goran-mahovlic/mppt-charge-controller/README.md

# MTTP Charge Controller

Adapted from Byte Sized Projects for MEGAphone
Used and released under GPLv3

# mppt charge controller
 
BQ 24650 datasheet can be found here https://www.ti.com/general/docs/suppproductinfo.tsp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
