goran-mahovlic/mppt-charge-controller/Electrical-Design/Solder Paste Jig.3mf

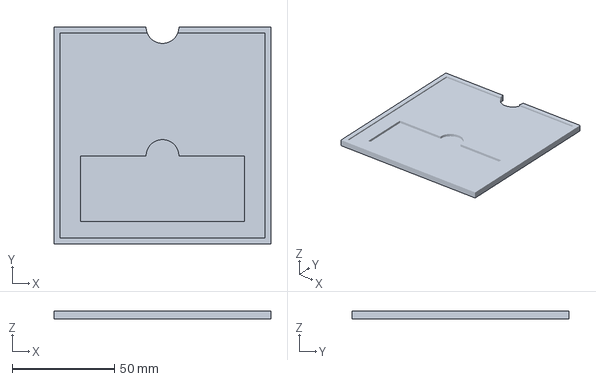
[picture p1: CAD file, 2025-08-11]
Electrical-Design/Solder Paste Jig.3mf
106.0 x 106.0 x 4.00 mm
