goran-mahovlic/mppt-charge-controller/Electrical-Design/MPPT-Charge-Controller-KiCad/MPPT Charge Controller.pdf

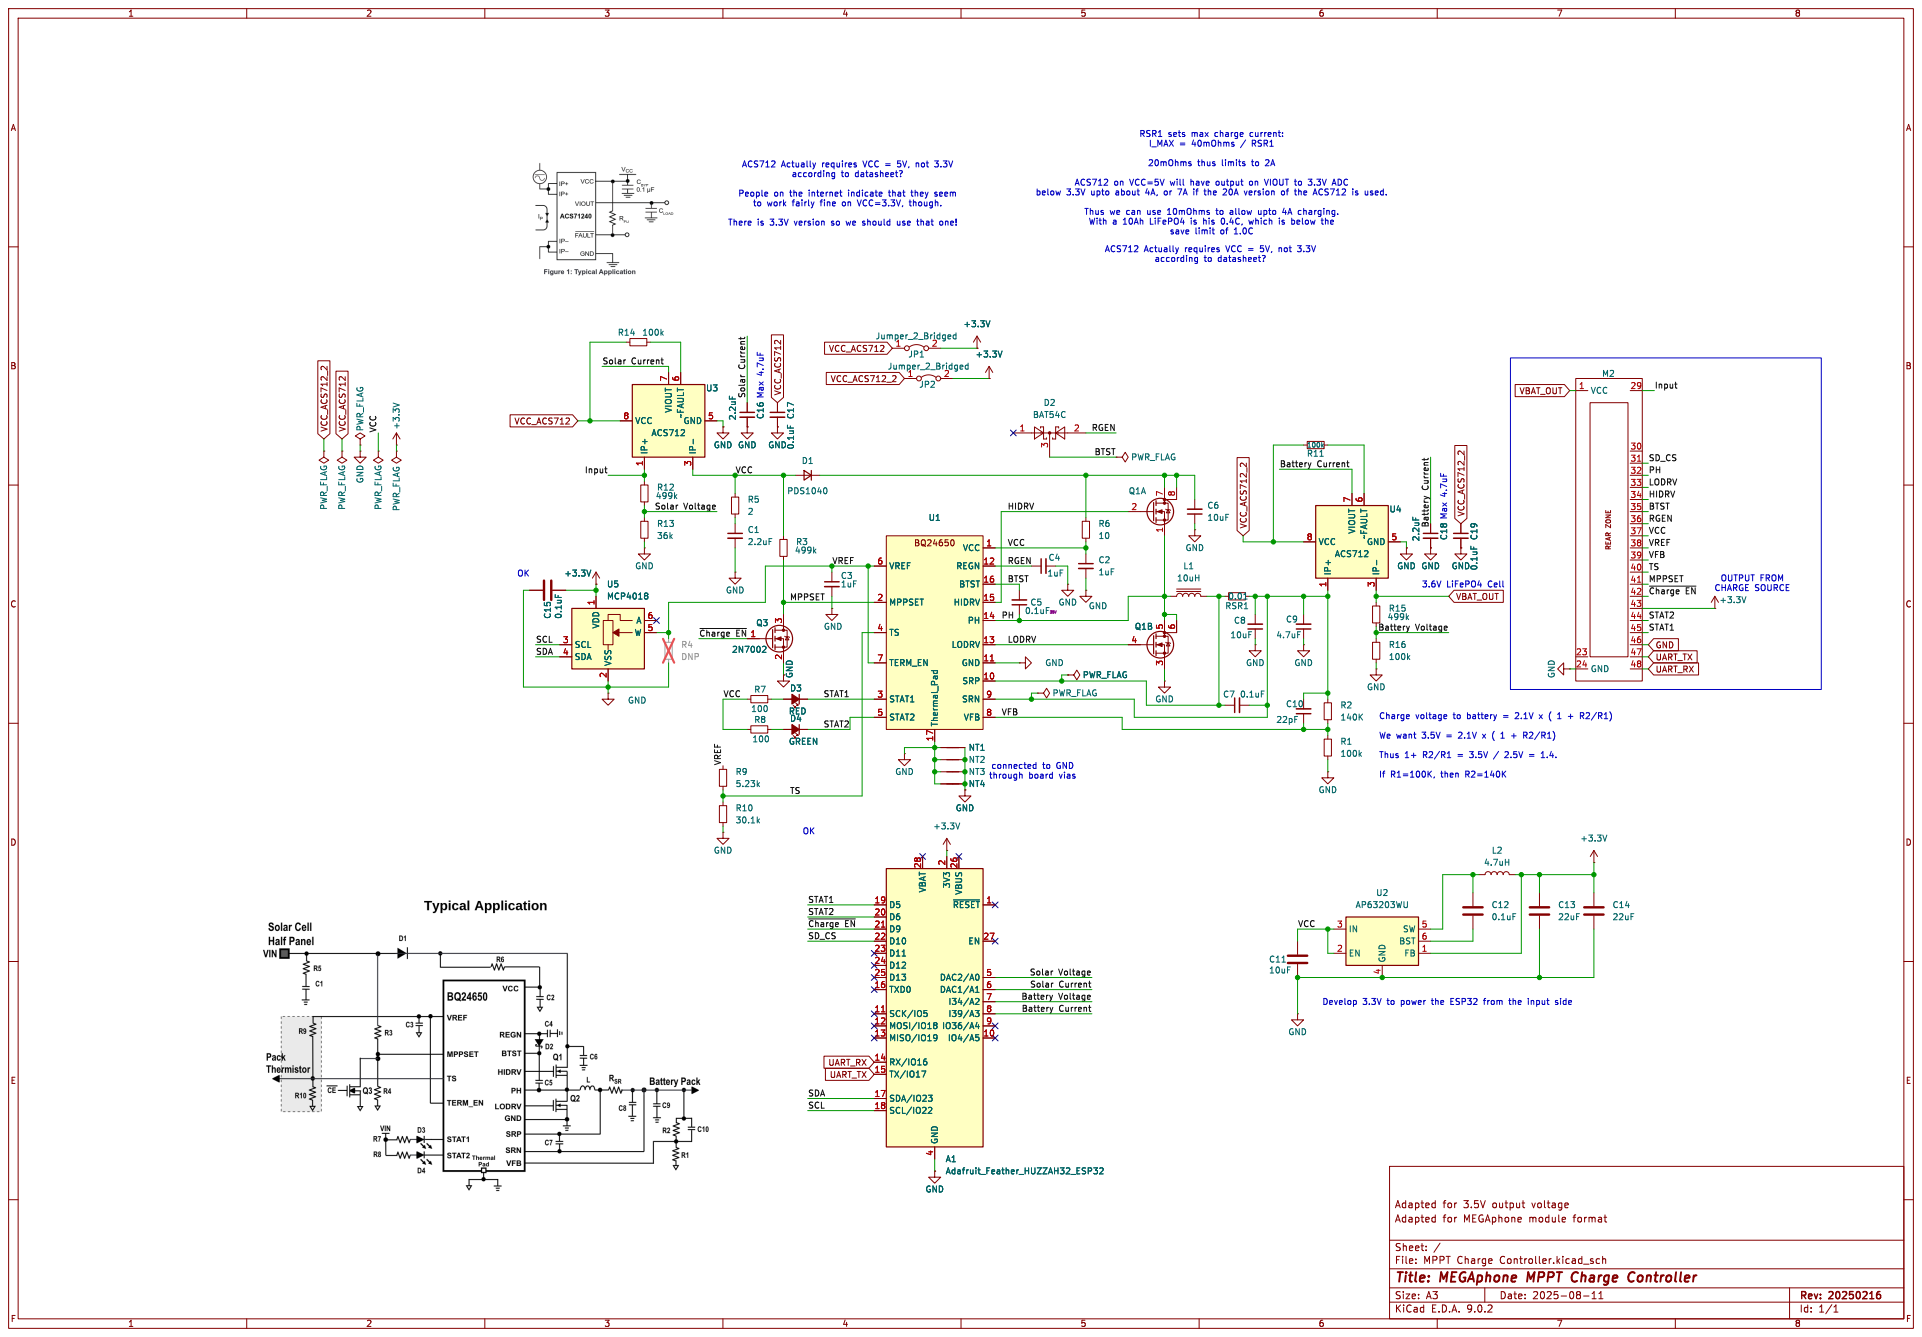
[picture p2: page 1]

RSR1 sets max charge current:
I_MAX = 40mOhms / RSR1

ACS712 on VCC=5V will have output on VIOUT to 3.3V ADC

below 3.3V upto about 4A, or 7A if the 20A version of the ACS712 is used. Thus we can use 10mOhms to allow upto 4A charging. With a 10Ah LiFePO4 is his 0.4C, which is below the

There is 3.3V version so we should use that one!

3.6V LiFePO4 Cell ACS712 Actually requires VCC = 5V, not 3.3V

1 IP- 3 VCC 8 GND 5 VIOUT

3 2 2.2uF C16 GND GND GND C17 0.1uF GND C19 GND 0.1uF U4 ACS712 IP+

Battery Current ~{Charge EN} VREF VCC
VCC

4 SW 5 BST 6 FB 1 U2 AP63203WU GND 2.2uF C18 R2
