goran-mahovlic/mppt-charge-controller/Electrical-Design/MPPT-Charge-Controller-KiCad/MPPT Charge Controller.kicad_pcb

## KiCad design Electrical-Design/MPPT-Charge-Controller-KiCad/MPPT Charge Controller.kicad_pcb (2025-08-13)

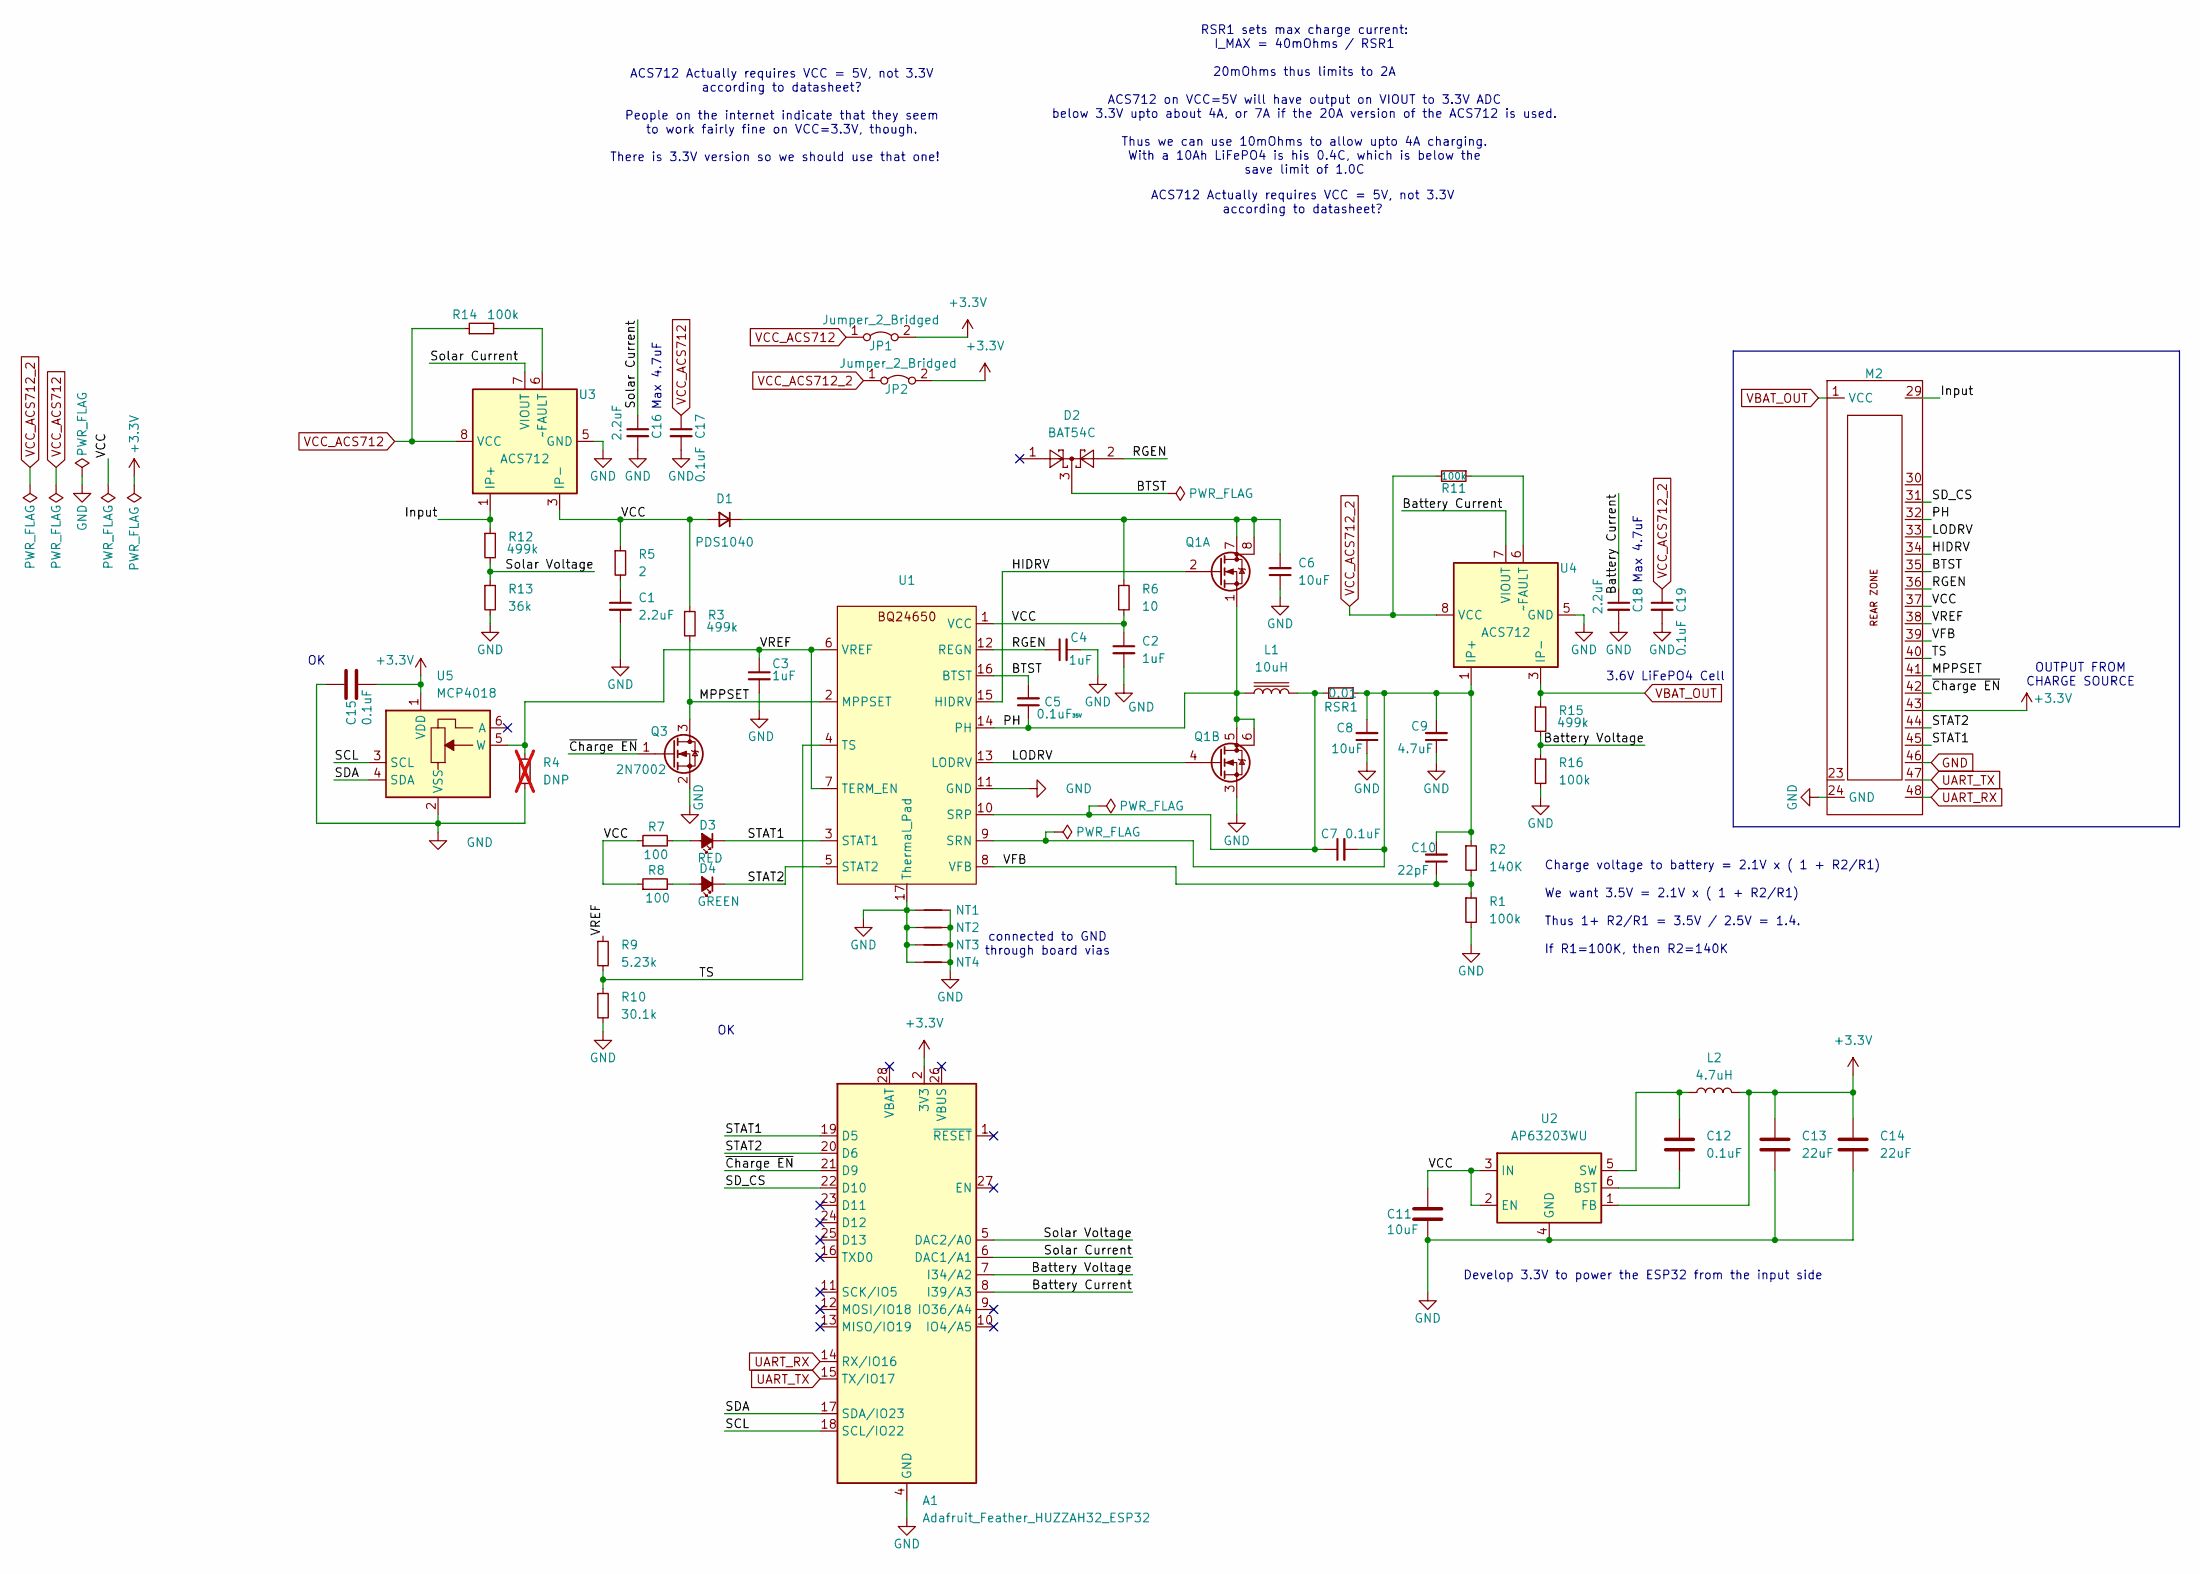
[picture p3: schematic MPPT Charge Controller.kicad_sch, MEGAphone MPPT Charge Controller]

Parts:
A1: Adafruit_Feather_HUZZAH32_ESP32; Adafruit_Feather
C1, C16, C18: 2.2uF; C_0603_1608Metric
C2, C3, C4: 1uF; C_0603_1608Metric
C5: 0.1uF; C_0603_1608Metric; Voltage Rating 35V
C6, C8: 10uF; C_1206_3216Metric
C7, C12, C15, C17, C19: 0.1uF; C_0603_1608Metric
C9: 4.7uF; C_0603_1608Metric
C10: 22pF; C_0603_1608Metric
C11: 10uF; C_0603_1608Metric
C13, C14: 22uF; C_0603_1608Metric
D1: PDS1040; D_PowerDI-5
D2: BAT54C; SOT-23
D3: RED; LED_0603_1608Metric
D4: GREEN; LED_0603_1608Metric
JP1, JP2: Jumper_2_Bridged; SolderJumper-2_P1.3mm_Bridged_RoundedPad1.0x1.5mm
L1: 10uH; L_Vishay_6.9x6.5
L2: 4.7uH; L_Vishay_IFSC-1515AH_4x4x1.8mm
M2: MegaCastle2x24-Module-I40.0x56.2-M8000030FFFFF-SPAREPAD
NT1, NT2, NT3, NT4: NetTie-2_SMD_Pad0.5mm
Q1: SI7272DP; PowerPAK_SO-8_Dual
Q3: 2N7002; SOT-23
R1, R11, R14, R16: 100k; R_0603_1608Metric
R2: 140K; R_0603_1608Metric
R3, R12, R15: 499k; R_0603_1608Metric
R4: DNP; R_0603_1608Metric; not fitted
R5: 2; R_2512_6332Metric
R6: 10; R_0603_1608Metric
R7, R8: 100; R_0603_1608Metric
R9: 5.23k; R_0603_1608Metric
R10: 30.1k; R_0603_1608Metric
R13: 36k; R_0603_1608Metric
RSR1: 0.01; R_1206_3216Metric
U1: VQFN-16_EP_3.5x3.5_Pitch0.5mm
U2: AP63203WU; TSOT-23-6
U3, U4: ACS712; SOIC-8_3.9x4.9mm_P1.27mm
U5: MCP4018; SOT-363_SC-70-6

Connections:
+3.3V: A1.2 (3V3), C13.1, C14.1, C15.1, JP1.2 (B), JP2.2 (B), L2.2, M2.43, U2.1 (FB), U5.1 (VDD)
/BTST: C5.2, D2.3, M2.35, U1.16 (BTST)
/Battery Current: A1.8 (I39/A3), C18.1, U4.7 (VIOUT)
/Battery Voltage: A1.7 (I34/A2), R15.2, R16.1
/HIDRV: M2.34, Q1.2 (G), U1.15 (HIDRV)
/Input: M2.29, R12.1, U3.1 (IP+), U3.2 (IP+)
/LODRV: M2.33, Q1.4 (G), U1.13 (LODRV)
/MPPSET: M2.41, Q3.3 (D), R3.2, U1.2 (MPPSET)
/PH: C5.1, L1.1, M2.32, Q1.1 (S), Q1.5 (D), Q1.6 (D), U1.14 (PH)
/RGEN: C4.1, D2.2, M2.36, U1.12 (REGN)
/SCL: A1.18 (SCL/IO22), U5.3 (SCL)
/SDA: A1.17 (SDA/IO23), U5.4 (SDA)
/SD_CS: A1.22 (D10), M2.31
/STAT1: A1.19 (D5), D3.1 (K), M2.45, U1.3 (STAT1)
/STAT2: A1.20 (D6), D4.1 (K), M2.44, U1.5 (STAT2)
/Solar Current: A1.6 (DAC1/A1), C16.1, U3.7 (VIOUT)
/Solar Voltage: A1.5 (DAC2/A0), R12.2, R13.1
/TS: M2.40, R9.2, R10.1, U1.4 (TS)
/VCC: C2.1, C11.2, D1.2 (A), M2.37, R3.1, R5.1, R6.2, R7.1, R8.1, U1.1 (VCC), U2.2 (EN), U2.3 (IN), U3.3 (IP-), U3.4 (IP-)
/VFB: C10.1, M2.39, R1.1, R2.2, U1.8 (VFB)
/VREF: C3.1, M2.38, R4.1, R9.1, U1.6 (VREF), U1.7 (TERM_EN), U5.5 (W)
/~Charge EN: A1.21 (D9), M2.42, Q3.1 (G)
GND: A1.4 (GND), C1.2, C2.2, C3.2, C4.2, C6.1, C8.1, C9.1, C11.1, C13.2, C14.2, C15.2, C16.2, C17.2, C18.2, C19.2, M2.24 (GND), M2.46, NT1.1, NT1.2, NT2.1, NT2.2, NT3.1, NT3.2, NT4.1, NT4.2, Q1.3 (S), Q3.2 (S), R1.2, R4.2, R10.2, R13.2, R16.2, U1.11 (GND), U1.17 (Thermal_Pad), U2.4 (GND), U3.5 (GND), U4.5 (GND), U5.2 (VSS)
unnamed: C1.1, R5.2
unnamed: C6.2, D1.1 (K), Q1.7 (D), Q1.8 (D), R6.1
unnamed: D3.2 (A), R7.2
unnamed: D4.2 (A), R8.2
unnamed: C7.2, C8.2, C9.2, C10.2, R2.1, RSR1.1, U1.9 (SRN), U4.1 (IP+), U4.2 (IP+)
unnamed: C7.1, L1.2, RSR1.2, U1.10 (SRP)
unnamed: C12.2, U2.6 (BST)
unnamed: C12.1, L2.1, U2.5 (SW)
unnamed: R14.2, U3.6 (~FAULT)
unnamed: R11.1, U4.6 (~FAULT)
UART_RX: A1.14 (RX/IO16), M2.48
UART_TX: A1.15 (TX/IO17), M2.47
VBAT_OUT: M2.1 (VCC), R15.1, U4.3 (IP-), U4.4 (IP-)
VCC_ACS712: C17.1, JP1.1 (A), R14.1, U3.8 (VCC)
VCC_ACS712_2: C19.1, JP2.1 (A), R11.2, U4.8 (VCC)

Notes on the sheet:
ACS712 Actually requires VCC = 5V, not 3.3V according to datasheet?
ACS712 Actually requires VCC = 5V, not 3.3V according to datasheet? People on the internet indicate that they seem to work fairly fine on VCC=3.3V, though.
Max 4.7uF
3.6V LiFePO4 Cell
OUTPUT FROM CHARGE SOURCE
Charge voltage to battery = 2.1V x ( 1 + R2/R1) We want 3.5V = 2.1V x ( 1 + R2/R1) Thus 1+ R2/R1 = 3.5V / 2.5V = 1.4. If R1=100K, then R2=140K
RSR1 sets max charge current: I_MAX = 40mOhms / RSR1 20mOhms thus limits to 2A ACS712 on VCC=5V will have output on VIOUT to 3.3V ADC below 3.3V upto about 4A, or 7A if the 20A version of the ACS712 is used. Thus we can use 10mOhms to allow upto 4A charging. With a 10Ah LiFePO4 is his 0.4C, which i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
There is 3.3V version so we should use that one!
connected to GND through board vias
Develop 3.3V to power the ESP32 from the input side

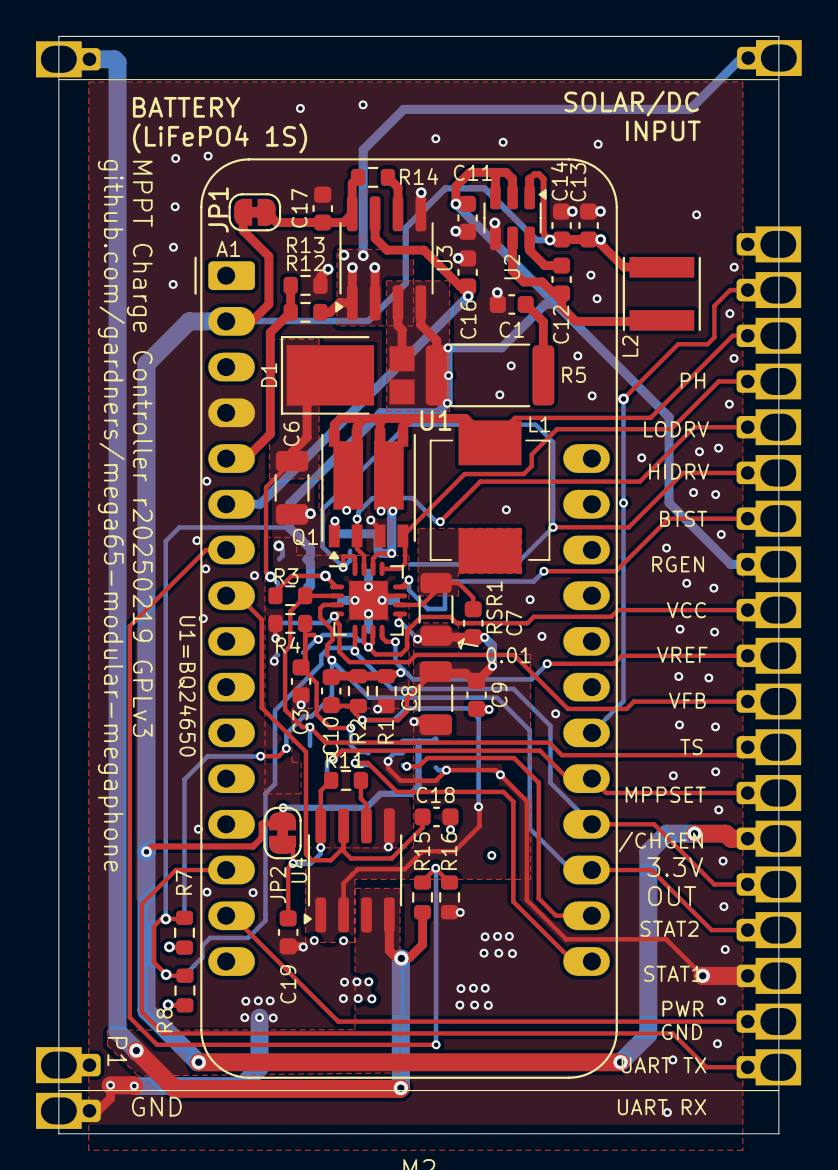
[picture p4: board MPPT Charge Controller.kicad_pcb from above]

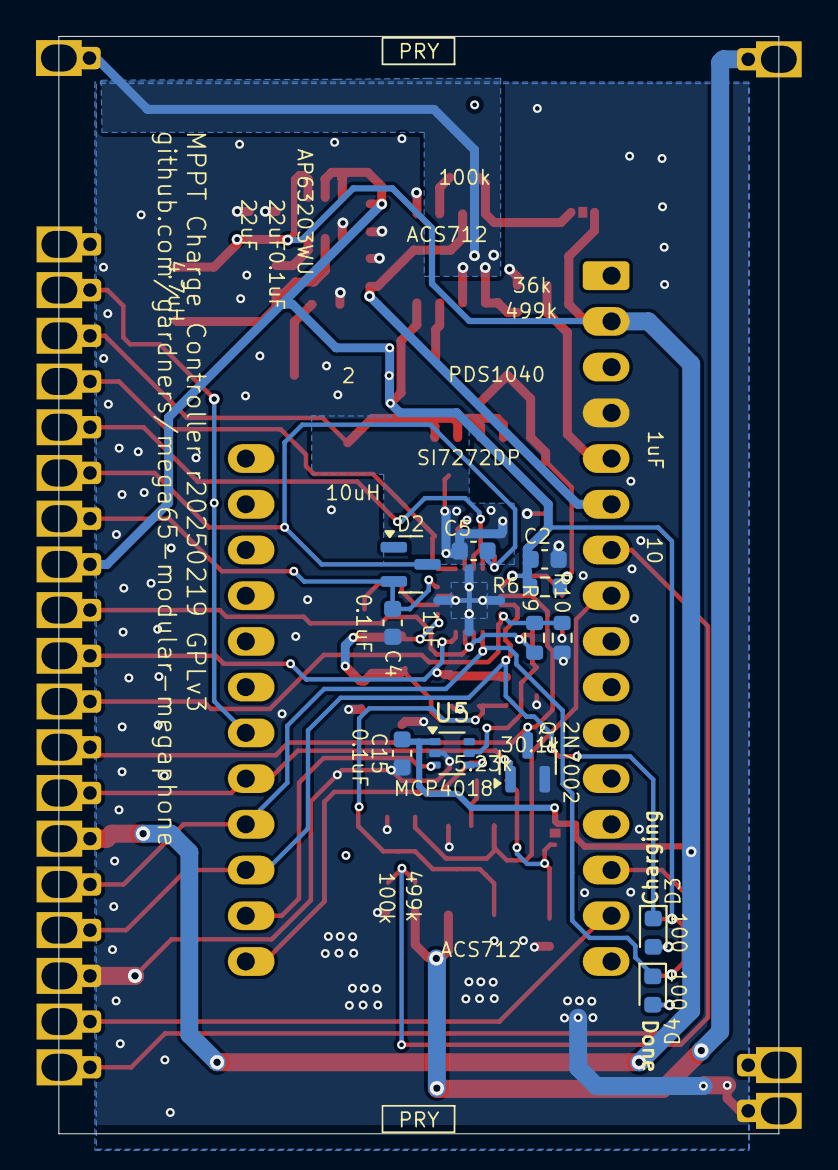
[picture p5: board MPPT Charge Controller.kicad_pcb from below]

Board: 4 copper layers, 40.0 x 61.0 mm, 57 parts (16 on the bottom side), 38 nets.
