goran-mahovlic/mppt-charge-controller/(commit log)

2025-02-09 update VBAT to 3.5V for single LiFePO4 cell
    [MPPT Charge Controller.kicad_sch]
2025-02-09 add measurement markers for main area of circuit.
    [MPPT Charge Controller.kicad_pcb]
2025-02-09 update PCB for 140K R2
    [MPPT Charge Controller.kicad_pcb]
2025-02-15 continue to adapt for MEGAphone
    [MPPT Charge Controller.kicad_pcb, MPPT Charge Controller.kicad_sch]
2025-02-15 resolve most DRC violations
    [MPPT Charge Controller.kicad_pcb]
2025-02-16 add silkscreen for all component values
    [MPPT Charge Controller.kicad_pcb, MPPT Charge Controller.kicad_sch]
2025-02-16 update module information on PCB
    [MPPT Charge Controller.kicad_sch]
2025-02-17 switch to panelised footprint
    [MPPT Charge Controller.kicad_pcb, MPPT Charge Controller.kicad_sch]
2025-02-17 finish panelising
    [MPPT Charge Controller.kicad_pcb]
2025-02-19 prepare for initial fabrication: No castellation, single instance
    [MPPT Charge Controller.kicad_pcb]
2025-08-11 Updating shematics - renaming
    [MPPT Charge Controller.kicad_pcb, MPPT Charge Controller.kicad_sch, Solder Paste Jig.3mf]
2025-08-11 Update schematics - delete tracks - 4 layer boards have only 2 signal layers
    [MPPT Charge Controller.kicad_pcb, MPPT Charge Controller.kicad_sch]
2025-08-13 Routing, adding schematics
    [MPPT Charge Controller.kicad_pcb]
