goran-mahovlic/mppt-charge-controller/(notices)

Notices in the files:
Electrical-Design/MPPT-Charge-Controller-KiCad/MPPT Charge Controller.kicad_pcb:
${TITLE} r20250219 GPLv3
